NicolasGtrrzProperty/Ecualizador-de-audio-de-tres-bandas/(commit log)

2026-09-25 Primeros pasos
    [pyvenv.cfg]
2026-09-25 Esquemas de circuitos
2026-09-25 Variantes del circuito
    [01_original.sch, 02_ajustado.sch, 03_comercial_E96.sch, 04_realce_graves.sch, 05_realce_medios.sch, 06_realce_agudos.sch]
